barbeque/little-drip/references/g77-button.jpg

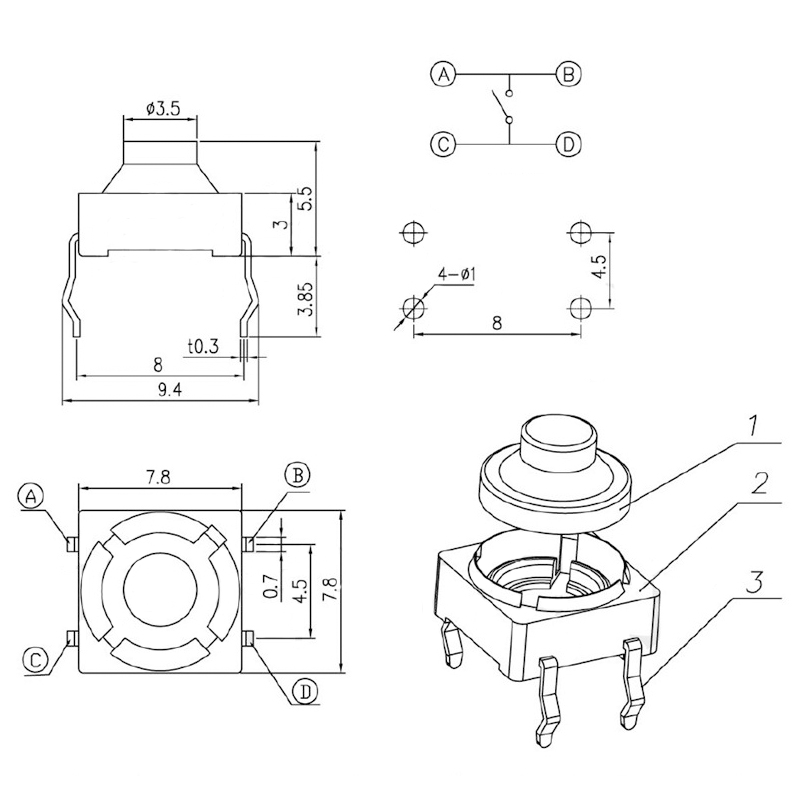
references/g77-button.jpg
