barbeque/little-drip/drip.kicad_pcb

## KiCad design drip.kicad_pcb (2023-03-24)

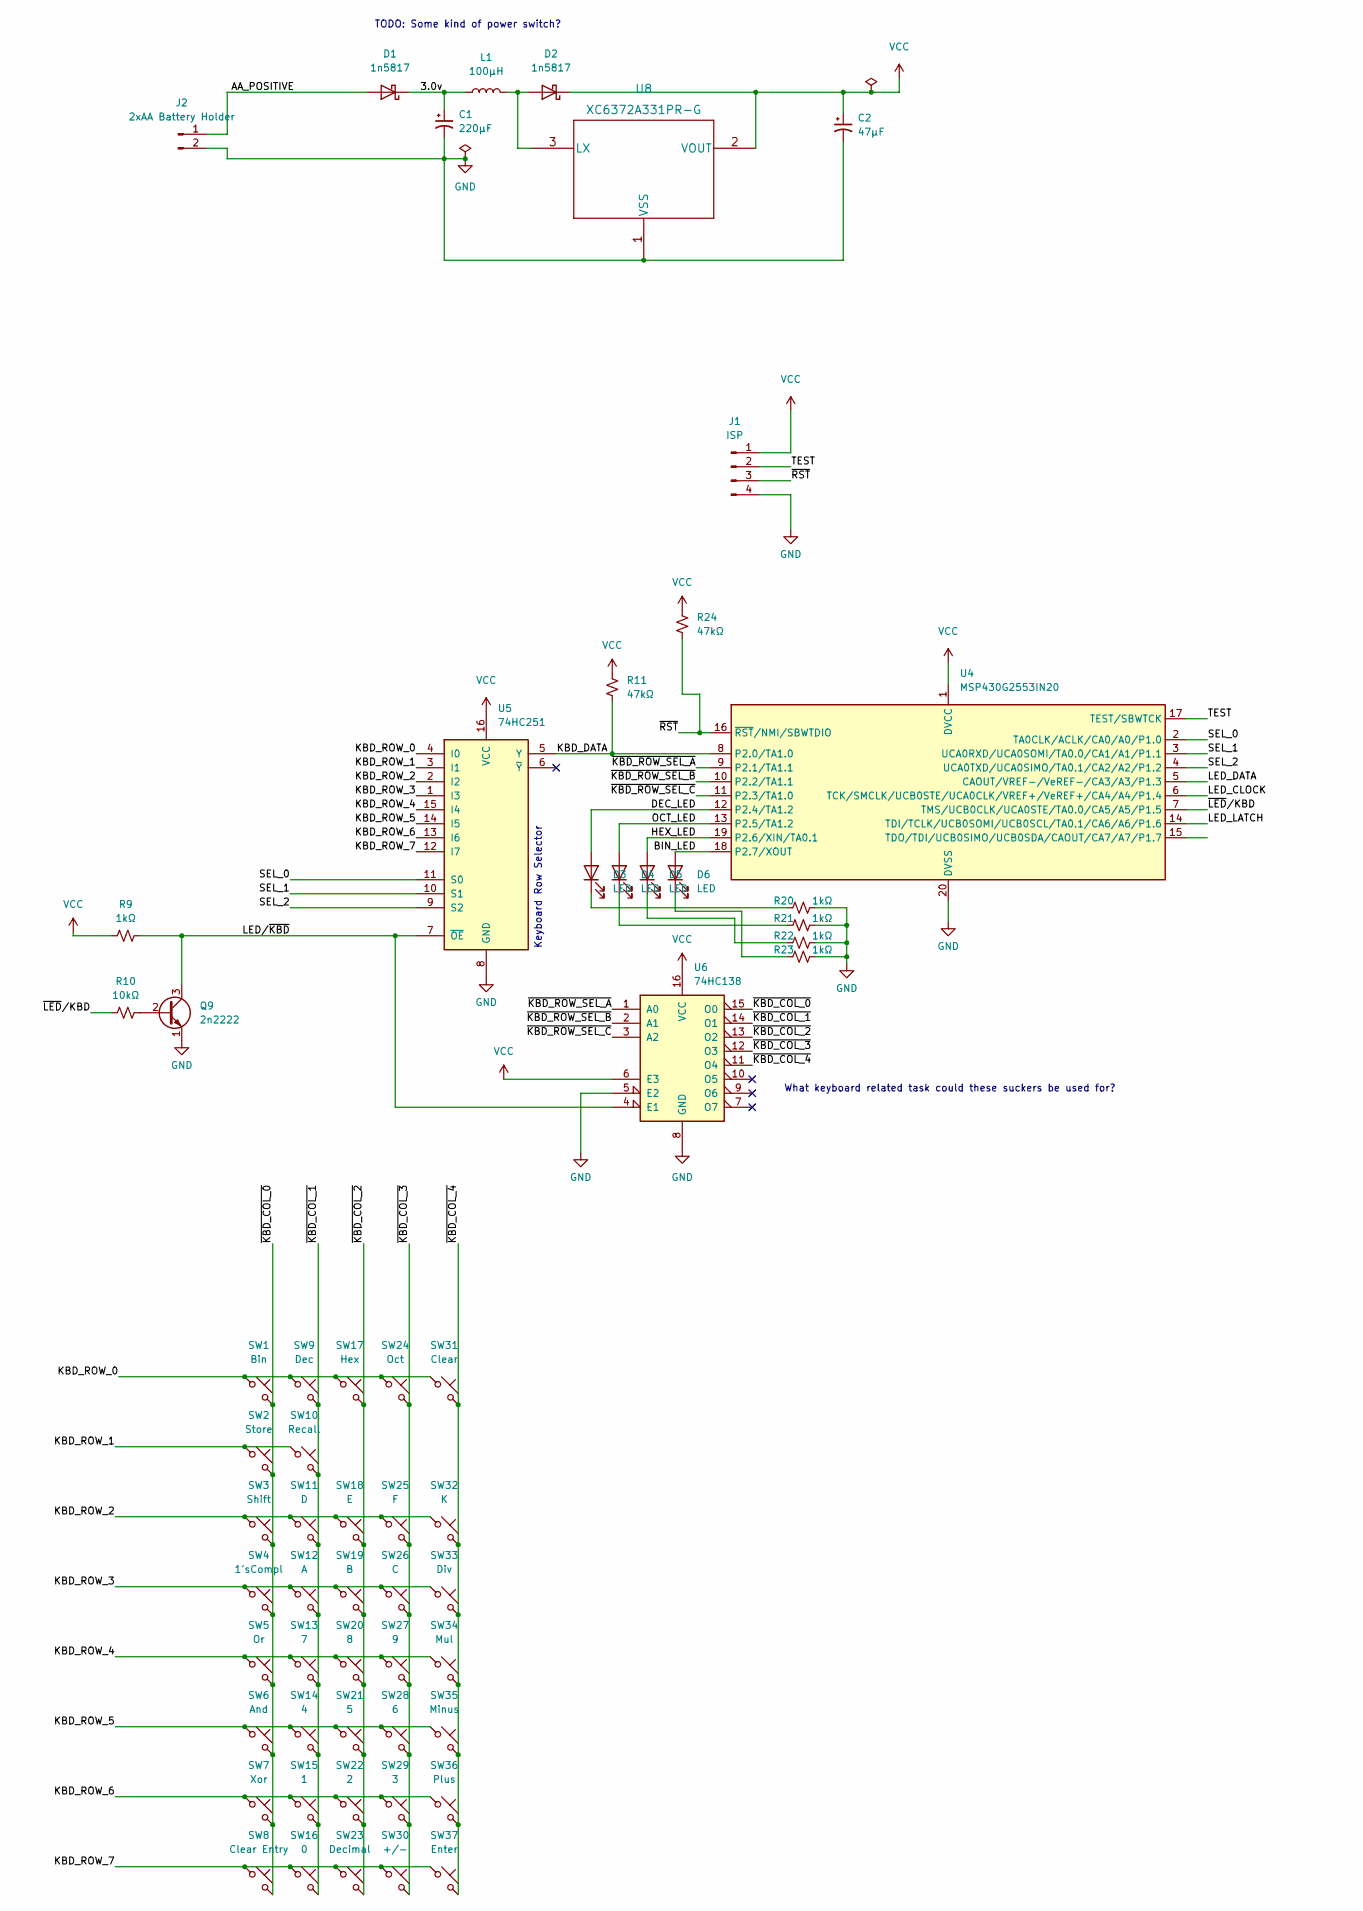
[picture p2: schematic drip.kicad_sch, part in row 1, column 1]

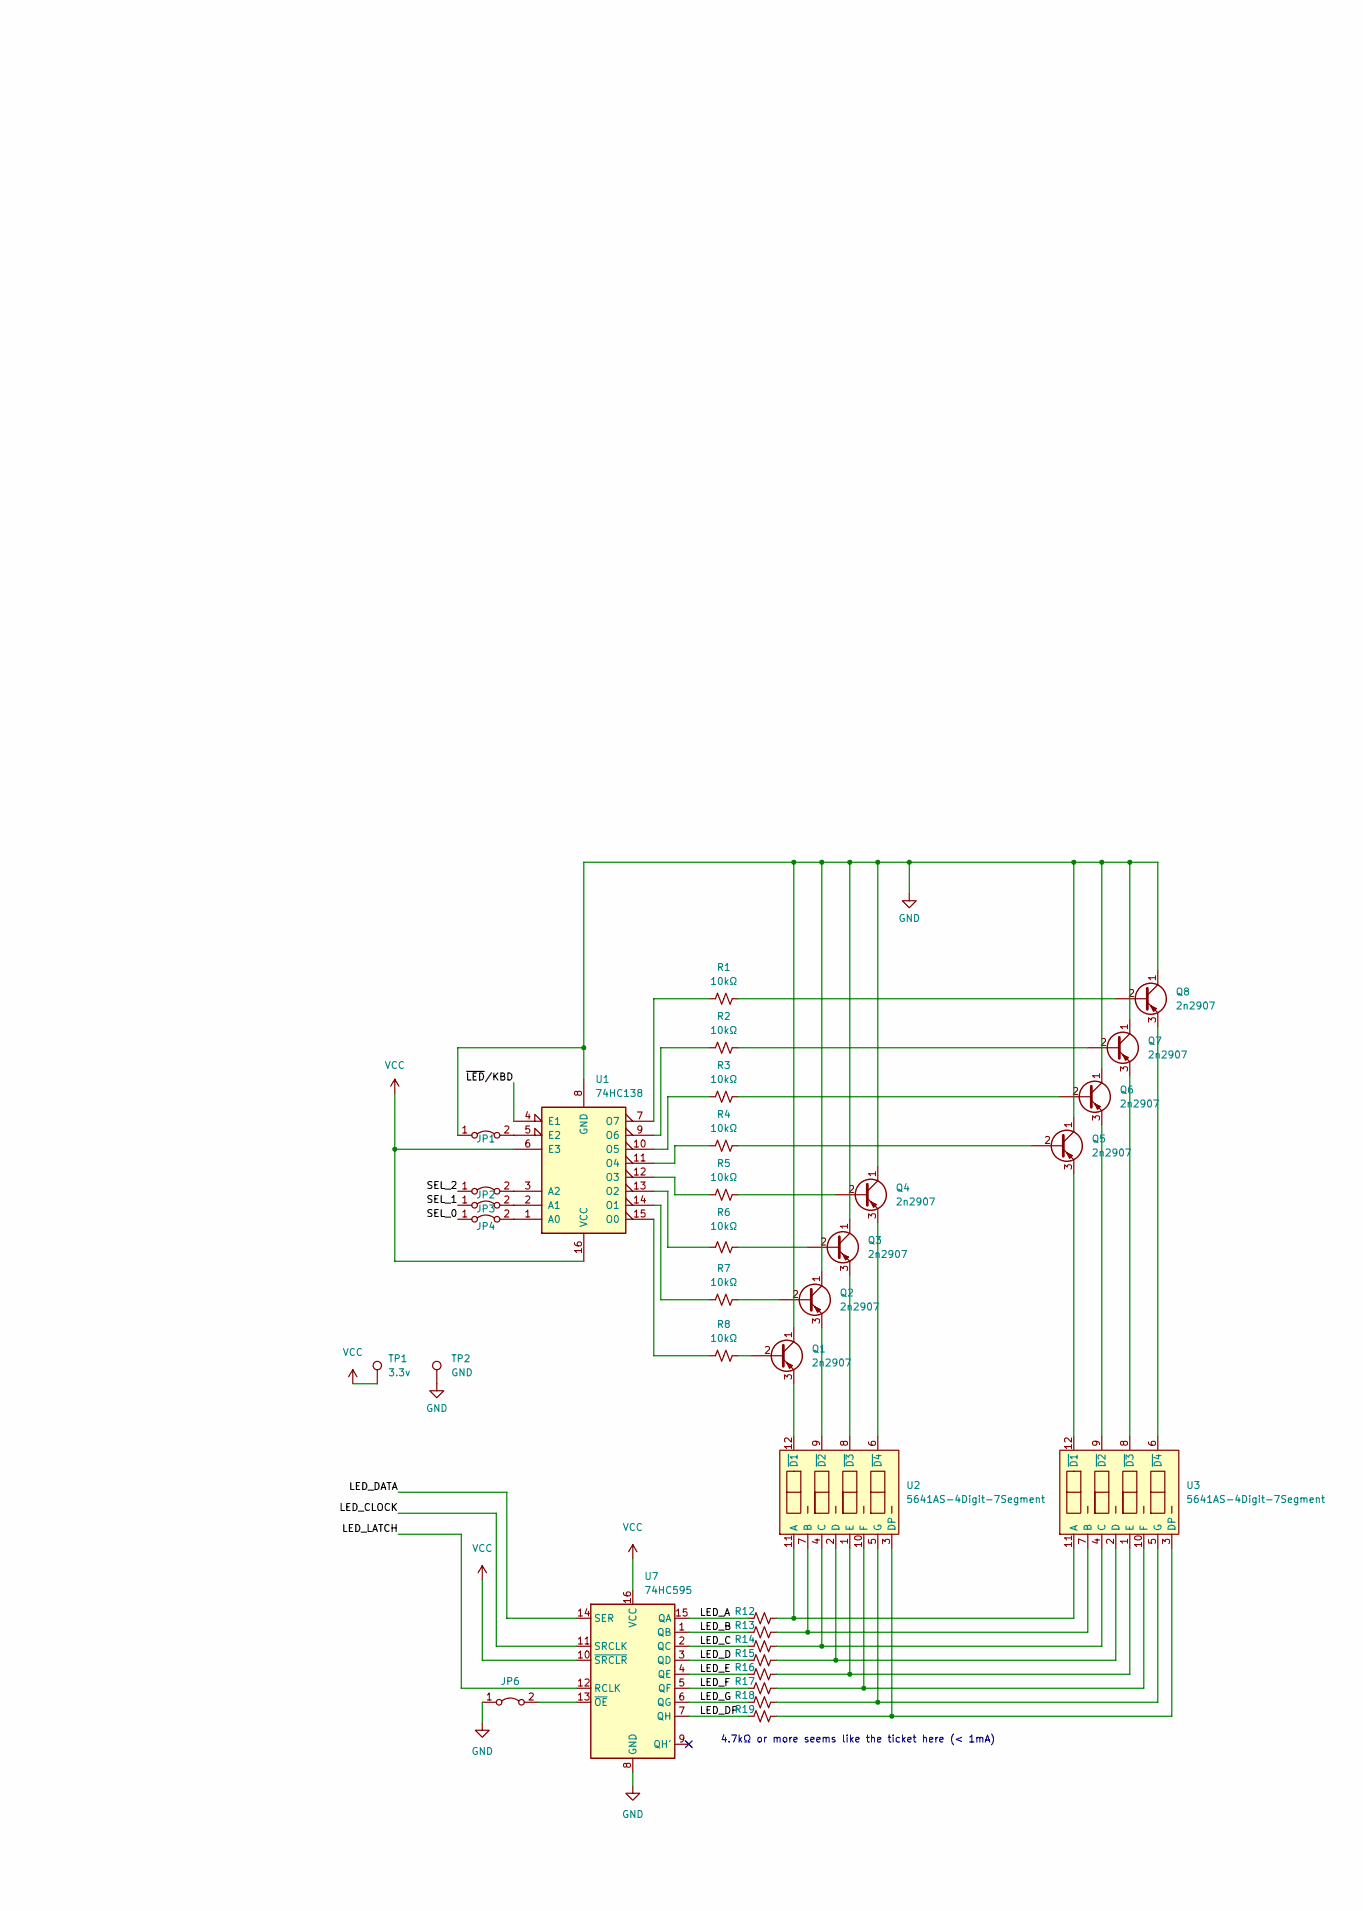
[picture p3: schematic drip.kicad_sch, part in row 1, column 2]

Parts:
C1: 220µF; CP_Radial_D8.0mm_P5.00mm
C2: 47µF; CP_EIA-3528-15_AVX-H_Pad1.50x2.35mm_HandSolder; DigiKey 718-293D476X0010B2TE3TR-ND
D1, D2: 1n5817; D_DO-41_SOD81_P10.16mm_Horizontal
D3, D4, D5, D6: LED; LED_0805_2012Metric_Pad1.15x1.40mm_HandSolder
J1: ISP; PinHeader_1x04_P2.54mm_Vertical
J2: 2xAA Battery Holder; BatteryHolder_MPD_BC2AAPC_2xAA; DigiKey BC2AAPC-ND
JP1, JP2, JP3, JP4, JP6: Jumper_2_Bridged; SolderJumper-2_P1.3mm_Bridged2Bar_RoundedPad1.0x1.5mm
L1: 100µH; L_0805_2012Metric_Pad1.15x1.40mm_HandSolder
Q1, Q2, Q3, Q4, Q5, Q6, Q7, Q8: 2n2907; TO-92_Inline
Q9: 2n2222; TO-92L_Inline
R1, R2, R3, R4, R5, R6, R7, R8, R10, R12, R13, R14, R15, R16, R17, R18, R19: 10kΩ; R_Axial_DIN0207_L6.3mm_D2.5mm_P10.16mm_Horizontal
R9: 1kΩ; R_Axial_DIN0207_L6.3mm_D2.5mm_P10.16mm_Horizontal
R11, R24: 47kΩ; R_Axial_DIN0207_L6.3mm_D2.5mm_P10.16mm_Horizontal
R20, R21, R22, R23: 1kΩ; R_0805_2012Metric_Pad1.20x1.40mm_HandSolder
SW1: Bin; 8mm_G77_Push
SW2: Store; 8mm_G77_Push
SW3: Shift; 8mm_G77_Push
SW4: 1'sCompl; 8mm_G77_Push
SW5: Or; 8mm_G77_Push
SW6: And; 8mm_G77_Push
SW7: Xor; 8mm_G77_Push
SW8: Clear Entry; 8mm_G77_Push
SW9: Dec; 8mm_G77_Push
SW10: Recall; 8mm_G77_Push
SW11: D; 8mm_G77_Push
SW12: A; 8mm_G77_Push
SW13: 7; 8mm_G77_Push
SW14: 4; 8mm_G77_Push
SW15: 1; 8mm_G77_Push
SW16: 0; 8mm_G77_Push
SW17: Hex; 8mm_G77_Push
SW18: E; 8mm_G77_Push
SW19: B; 8mm_G77_Push
SW20: 8; 8mm_G77_Push
SW21: 5; 8mm_G77_Push
SW22: 2; 8mm_G77_Push
SW23: Decimal; 8mm_G77_Push
SW24: Oct; 8mm_G77_Push
SW25: F; 8mm_G77_Push
SW26: C; 8mm_G77_Push
SW27: 9; 8mm_G77_Push
SW28: 6; 8mm_G77_Push
SW29: 3; 8mm_G77_Push
SW30: +/-; 8mm_G77_Push
SW31: Clear; 8mm_G77_Push
SW32: K; 8mm_G77_Push
SW33: Div; 8mm_G77_Push
SW34: Mul; 8mm_G77_Push
SW35: Minus; 8mm_G77_Push
SW36: Plus; 8mm_G77_Push
SW37: Enter; 8mm_G77_Push
TP1: 3.3v; TestPoint_Loop_D2.50mm_Drill1.85mm
TP2: GND; TestPoint_Loop_D2.50mm_Drill1.85mm
U1, U6: 74HC138; DIP-16_W7.62mm_Socket_LongPads
U2, U3: 5641AS-4Digit-7Segment; 5641AS_THT
U4: MSP430G2553IN20; DIP-20_W7.62mm
U5: 74HC251; DIP-16_W7.62mm_Socket_LongPads
U7: 74HC595; DIP-16_W7.62mm_Socket_LongPads
U8: XC6372A331PR-G; SOT-89-3_Handsoldering

Connections:
/3.0v: C1.1, D1.1 (K), L1.1
/AA_POSITIVE: D1.2 (A), J2.1
/BIN_LED: D6.2 (A), U4.18 (P2.7/XOUT)
/DEC_LED: D3.2 (A), U4.12 (P2.4/TA1.2)
/HEX_LED: D5.2 (A), U4.19 (P2.6/XIN/TA0.1)
/KBD_DATA: R11.2, U4.8 (P2.0/TA1.0), U5.5 (Y)
/KBD_ROW_0: SW1.1, SW9.1, SW17.1, SW24.1, SW31.1, U5.4 (I0)
/KBD_ROW_1: SW2.1, SW10.1, U5.3 (I1)
/KBD_ROW_2: SW3.1, SW11.1, SW18.1, SW25.1, SW32.1, U5.2 (I2)
/KBD_ROW_3: SW4.1, SW12.1, SW19.1, SW26.1, SW33.1, U5.1 (I3)
/KBD_ROW_4: SW5.1, SW13.1, SW20.1, SW27.1, SW34.1, U5.15 (I4)
/KBD_ROW_5: SW6.1, SW14.1, SW21.1, SW28.1, SW35.1, U5.14 (I5)
/KBD_ROW_6: SW7.1, SW15.1, SW22.1, SW29.1, SW36.1, U5.13 (I6)
/KBD_ROW_7: SW8.1, SW16.1, SW23.1, SW30.1, SW37.1, U5.12 (I7)
/LED_A: R12.1, U7.15 (QA)
/LED_B: R13.1, U7.1 (QB)
/LED_C: R14.1, U7.2 (QC)
/LED_CLOCK: U4.6 (TCK/SMCLK/UCB0STE/UCA0CLK/VREF+/VeREF+/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), U7.11 (SRCLK)
/LED_D: R15.1, U7.3 (QD)
/LED_DATA: U4.5 (CAOUT/VREF-/VeREF-/CA3/A3/P1.3), U7.14 (SER)
/LED_DP: R19.1, U7.7 (QH)
/LED_E: R16.1, U7.4 (QE)
/LED_F: R17.1, U7.5 (QF)
/LED_G: R18.1, U7.6 (QG)
/LED_LATCH: U4.14 (TDI/TCLK/UCB0SOMI/UCB0SCL/TA0.1/CA6/A6/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), U7.12 (RCLK)
/LED/~KBD: Q9.3 (C), R9.2, U5.7 (~OE), U6.4 (E1)
/OCT_LED: D4.2 (A), U4.13 (P2.5/TA1.2)
/SEL_0: JP4.1 (A), U4.2 (TA0CLK/ACLK/CA0/A0/P1.0), U5.11 (S0)
/SEL_1: JP3.1 (A), U4.3 (UCA0RXD/UCA0SOMI/TA0.0/CA1/A1/P1.1), U5.10 (S1)
/SEL_2: JP2.1 (A), U4.4 (UCA0TXD/UCA0SIMO/TA0.1/CA2/A2/P1.2), U5.9 (S2)
/TEST: J1.2, U4.17 (TEST/SBWTCK)
/~KBD_COL_0: SW1.2, SW2.2, SW3.2, SW4.2, SW5.2, SW6.2, SW7.2, SW8.2, U6.15 (O0)
/~KBD_COL_1: SW9.2, SW10.2, SW11.2, SW12.2, SW13.2, SW14.2, SW15.2, SW16.2, U6.14 (O1)
/~KBD_COL_2: SW17.2, SW18.2, SW19.2, SW20.2, SW21.2, SW22.2, SW23.2, U6.13 (O2)
/~KBD_COL_3: SW24.2, SW25.2, SW26.2, SW27.2, SW28.2, SW29.2, SW30.2, U6.12 (O3)
/~KBD_COL_4: SW31.2, SW32.2, SW33.2, SW34.2, SW35.2, SW36.2, SW37.2, U6.11 (O4)
/~KBD_ROW_SEL_A: U4.9 (P2.1/TA1.1), U6.1 (A0)
/~KBD_ROW_SEL_B: U4.10 (P2.2/TA1.1), U6.2 (A1)
/~KBD_ROW_SEL_C: U4.11 (P2.3/TA1.0), U6.3 (A2)
/~LED/KBD: R10.1, U1.4 (E1), U4.7 (TMS/UCB0CLK/UCA0STE/TA0.0/CA5/A5/P1.5)
/~RST: J1.3, R24.2, U4.16 (~RST/NMI/SBWTDIO)
GND: C1.2, C2.2, J1.4, J2.2, JP1.1 (A), JP6.1 (A), Q1.1 (C), Q2.1 (C), Q3.1 (C), Q4.1 (C), Q5.1 (C), Q6.1 (C), Q7.1 (C), Q8.1 (C), Q9.1 (E), R20.2, R21.2, R22.2, R23.2, TP2.1, U1.8 (GND), U4.20 (DVSS), U5.8 (GND), U6.5 (E2), U6.8 (GND), U7.8 (GND), U8.1 (VSS)
unnamed: D2.2 (A), L1.2, U8.3 (LX)
unnamed: D3.1 (K), R20.1
unnamed: D4.1 (K), R21.1
unnamed: D5.1 (K), R22.1
unnamed: D6.1 (K), R23.1
unnamed: JP1.2 (B), U1.5 (E2)
unnamed: JP2.2 (B), U1.3 (A2)
unnamed: JP3.2 (B), U1.2 (A1)
unnamed: JP4.2 (B), U1.1 (A0)
unnamed: JP6.2 (B), U7.13 (~OE)
unnamed: Q1.2 (B), R8.2
unnamed: Q1.3 (E), U2.12 (~D1)
unnamed: Q2.2 (B), R7.2
unnamed: Q2.3 (E), U2.9 (~D2)
unnamed: Q3.2 (B), R6.2
unnamed: Q3.3 (E), U2.8 (~D3)
unnamed: Q4.2 (B), R5.2
unnamed: Q4.3 (E), U2.6 (~D4)
unnamed: Q5.2 (B), R4.2
unnamed: Q5.3 (E), U3.12 (~D1)
unnamed: Q6.2 (B), R3.2
unnamed: Q6.3 (E), U3.9 (~D2)
unnamed: Q7.2 (B), R2.2
unnamed: Q7.3 (E), U3.8 (~D3)
unnamed: Q8.2 (B), R1.2
unnamed: Q8.3 (E), U3.6 (~D4)
unnamed: Q9.2 (B), R10.2
unnamed: R1.1, U1.7 (O7)
unnamed: R2.1, U1.9 (O6)
unnamed: R3.1, U1.10 (O5)
unnamed: R4.1, U1.11 (O4)
unnamed: R5.1, U1.12 (O3)
unnamed: R6.1, U1.13 (O2)
unnamed: R7.1, U1.14 (O1)
unnamed: R8.1, U1.15 (O0)
unnamed: R12.2, U2.11 (A), U3.11 (A)
unnamed: R13.2, U2.7 (B), U3.7 (B)
unnamed: R14.2, U2.4 (C), U3.4 (C)
unnamed: R15.2, U2.2 (D), U3.2 (D)
unnamed: R16.2, U2.1 (E), U3.1 (E)
unnamed: R17.2, U2.10 (F), U3.10 (F)
unnamed: R18.2, U2.5 (G), U3.5 (G)
unnamed: R19.2, U2.3 (DP), U3.3 (DP)
VCC: C2.1, D2.1 (K), J1.1, R9.1, R11.1, R24.1, TP1.1, U1.6 (E3), U1.16 (VCC), U4.1 (DVCC), U5.16 (VCC), U6.6 (E3), U6.16 (VCC), U7.10 (~SRCLR), U7.16 (VCC), U8.2 (VOUT)

Notes on the sheet:
TODO: Some kind of power switch?
Keyboard Row Selector
4.7kΩ or more seems like the ticket here (< 1mA)
What keyboard related task could these suckers be used for?

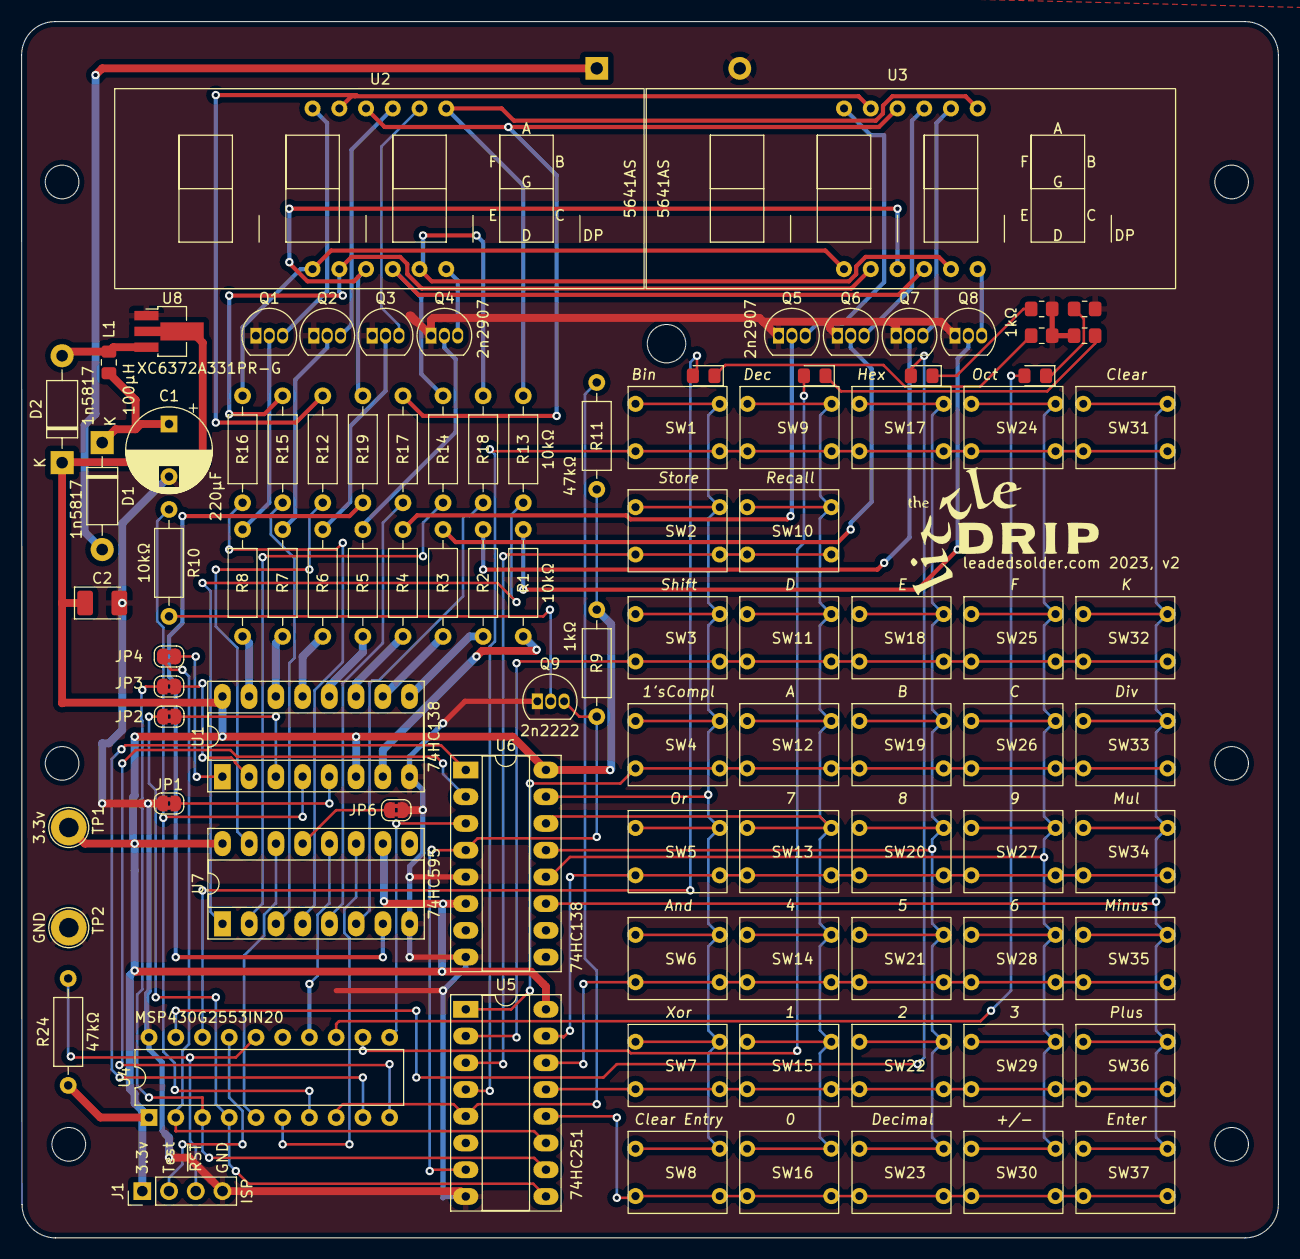
[picture p4: board drip.kicad_pcb from above]

Board: 2 copper layers, 119.4 x 115.6 mm, 96 parts (1 on the bottom side), 86 nets.
