barbeque/little-drip/(commit log)

2023-01-03 Starting to lay out the 7Seg
    [drip.kicad_pcb, drip.kicad_sch]
2023-01-09 PNP transistors to prepare for '138 based
    [drip.kicad_pcb, drip.kicad_sch]
2023-01-09 Add a ridiculous logo
    [drip.kicad_pcb]
2023-01-18 Untested first draft at 5641AS 7-seg 4-digit LED
    [drip.kicad_sch]
2023-01-18 '138 wired up
    [drip.kicad_sch]
2023-01-25 LED driver done
    [drip.kicad_pcb, drip.kicad_sch]
2023-01-25 Reducing pins
    [drip.kicad_sch]
2023-01-25 Keyboard row decode
    [drip.kicad_sch]
2023-01-25 Keyboard column decode
    [drip.kicad_sch]
2023-01-25 Wire the keyboard matrix properly this time
    [drip.kicad_sch]
2023-01-25 Fix inverted select
    [drip.kicad_sch]
2023-01-25 Use 10k on 7seg data lines
    [drip.kicad_sch]
2023-01-25 Button footprint, maybe
    [drip.kicad_pcb, drip.kicad_sch]
2023-01-25 Make holes larger for 8mm
2023-01-26 Fully footprinted schematic
    [drip.kicad_sch]
2023-01-26 2xAA holder
    [drip.kicad_pcb, drip.kicad_sch]
2023-01-26 Step-up converter, layout of keypad
    [drip.kicad_pcb, drip.kicad_sch]
2023-01-26 Minor PCB fettling
    [drip.kicad_pcb]
2023-01-26 All placed, kind of
    [drip.kicad_pcb]
2023-01-26 layout complete, lots of warnings
    [drip.kicad_pcb]
2023-01-26 Test hooks
    [drip.kicad_pcb, drip.kicad_sch]
2023-01-26 Silkscreen warnings dealt with
    [drip.kicad_pcb]
2023-01-27 Mode LEDs
    [drip.kicad_pcb, drip.kicad_sch]
2023-03-23 Reset pullup, move test hooks further apart
    [drip.kicad_pcb, drip.kicad_sch]
2023-03-24 7-segment working with latch bodge
    [drip.kicad_pcb, drip.kicad_sch]
2023-04-03 Working keyboard scanner, I think
    [drip.kicad_sch]
